1sadtrombone/rf-switch-firmware/boards/RF_control_board_v4.1/schematic.pdf

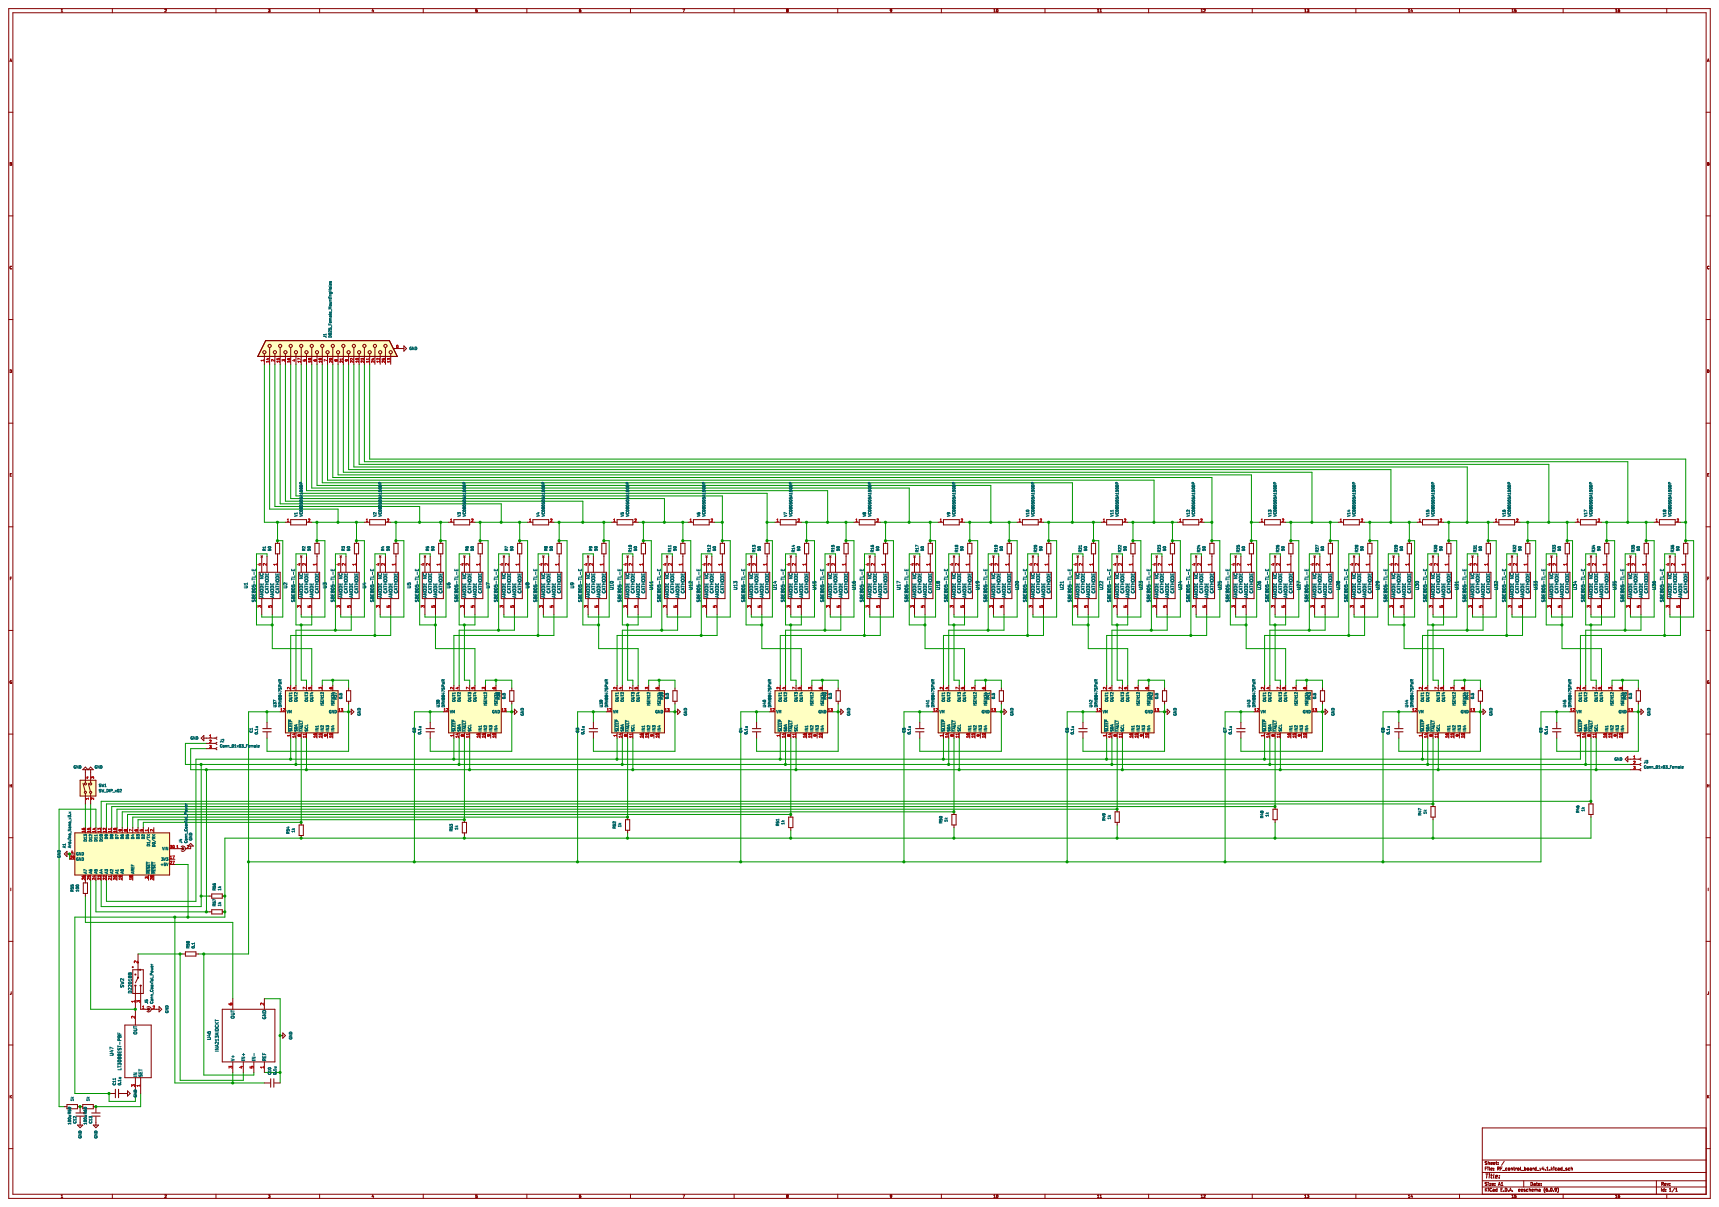
[picture p1: page 1]
