1sadtrombone/rf-switch-firmware/boards/RF_control_board_v2/schematic.pdf

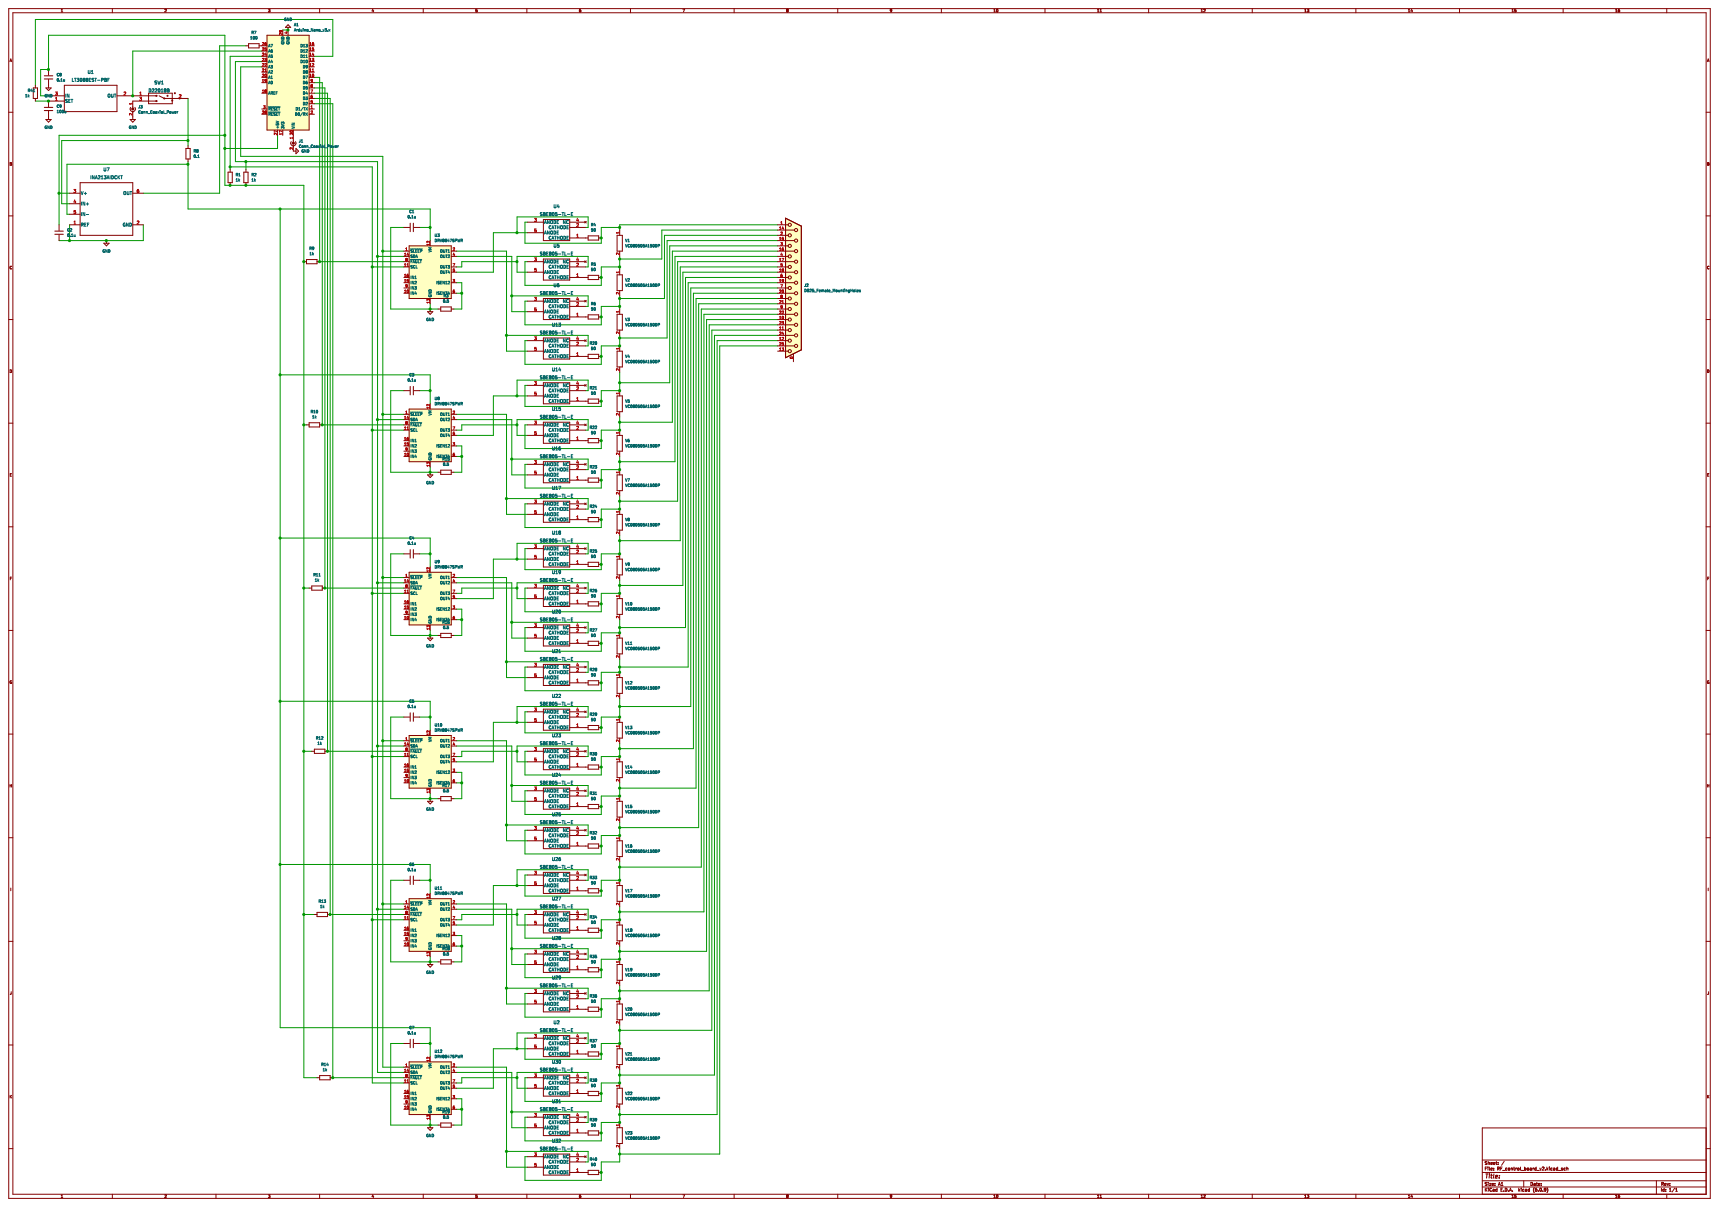
[picture p2: page 1]
