1sadtrombone/rf-switch-firmware/boards/RF_control_board_v2/RF_control_board_v2.kicad_pcb

## KiCad design boards/RF_control_board_v2/RF_control_board_v2.kicad_pcb (2023-06-08, an earlier design)

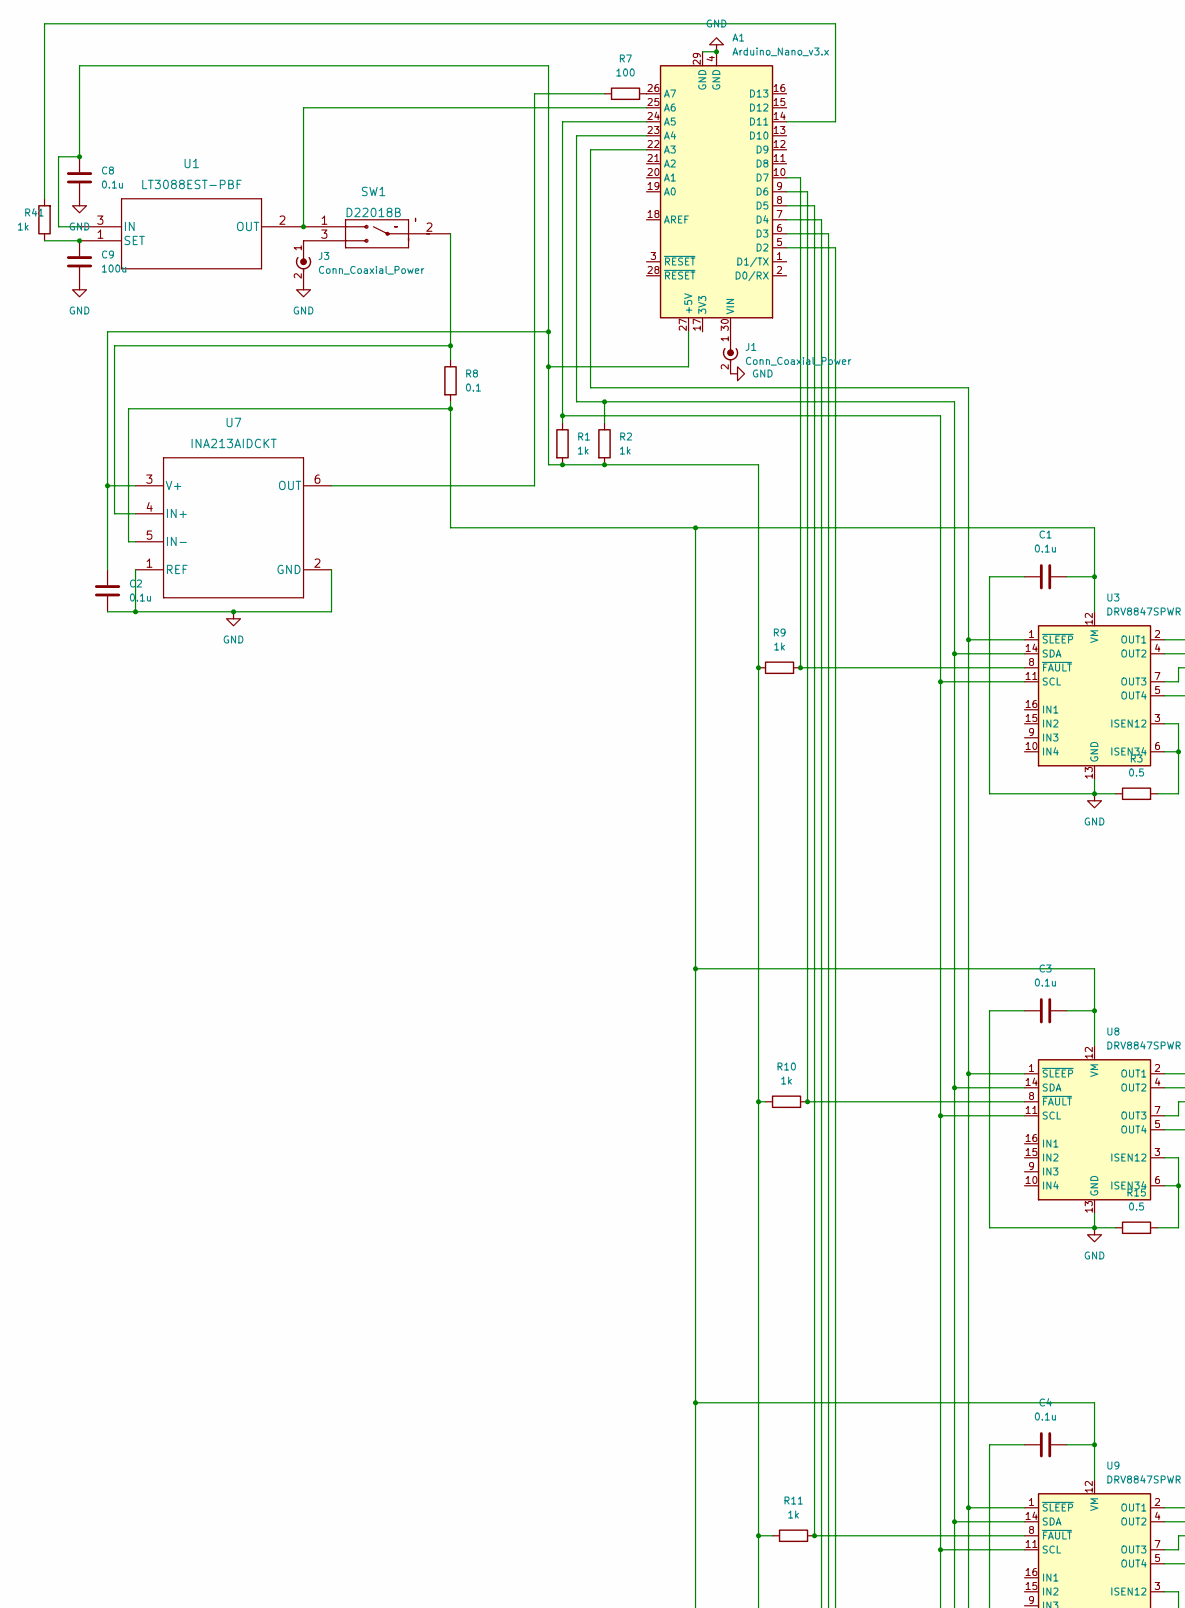
[picture p3: schematic RF_control_board_v2.kicad_sch, part in row 1, column 1]

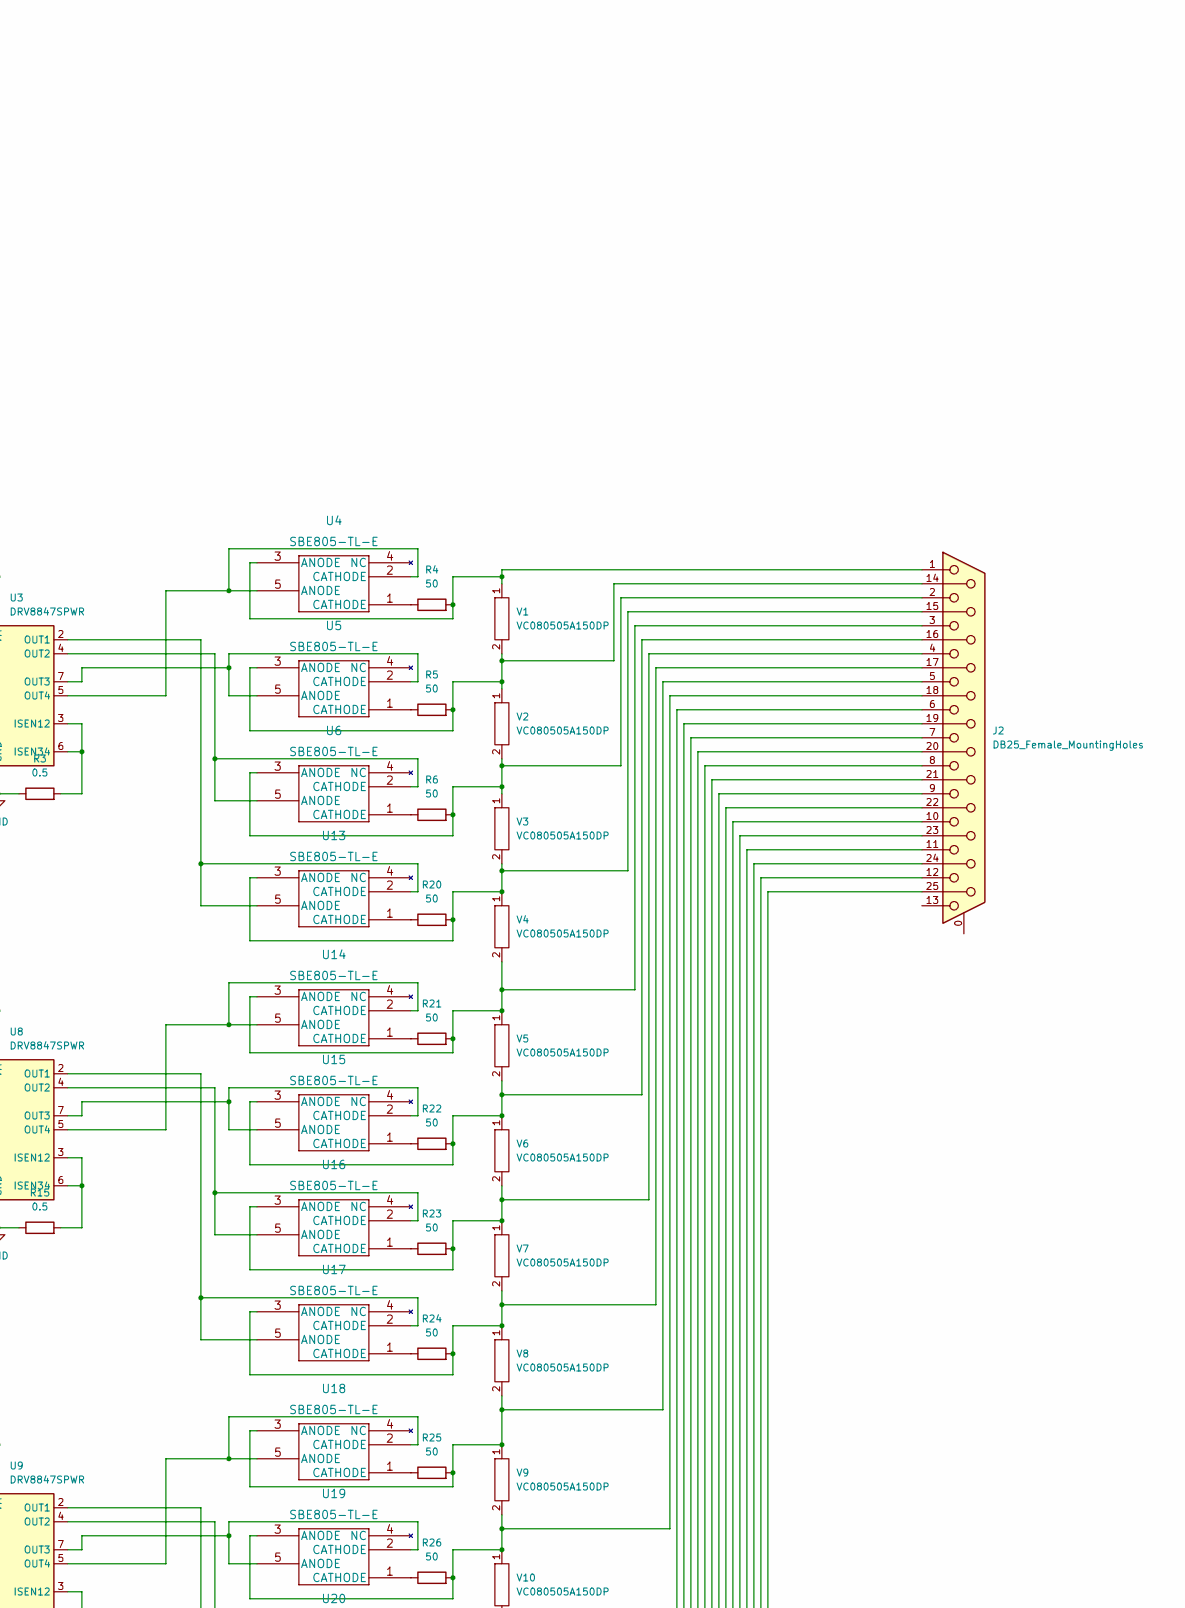
[picture p4: schematic RF_control_board_v2.kicad_sch, part in row 1, column 2]

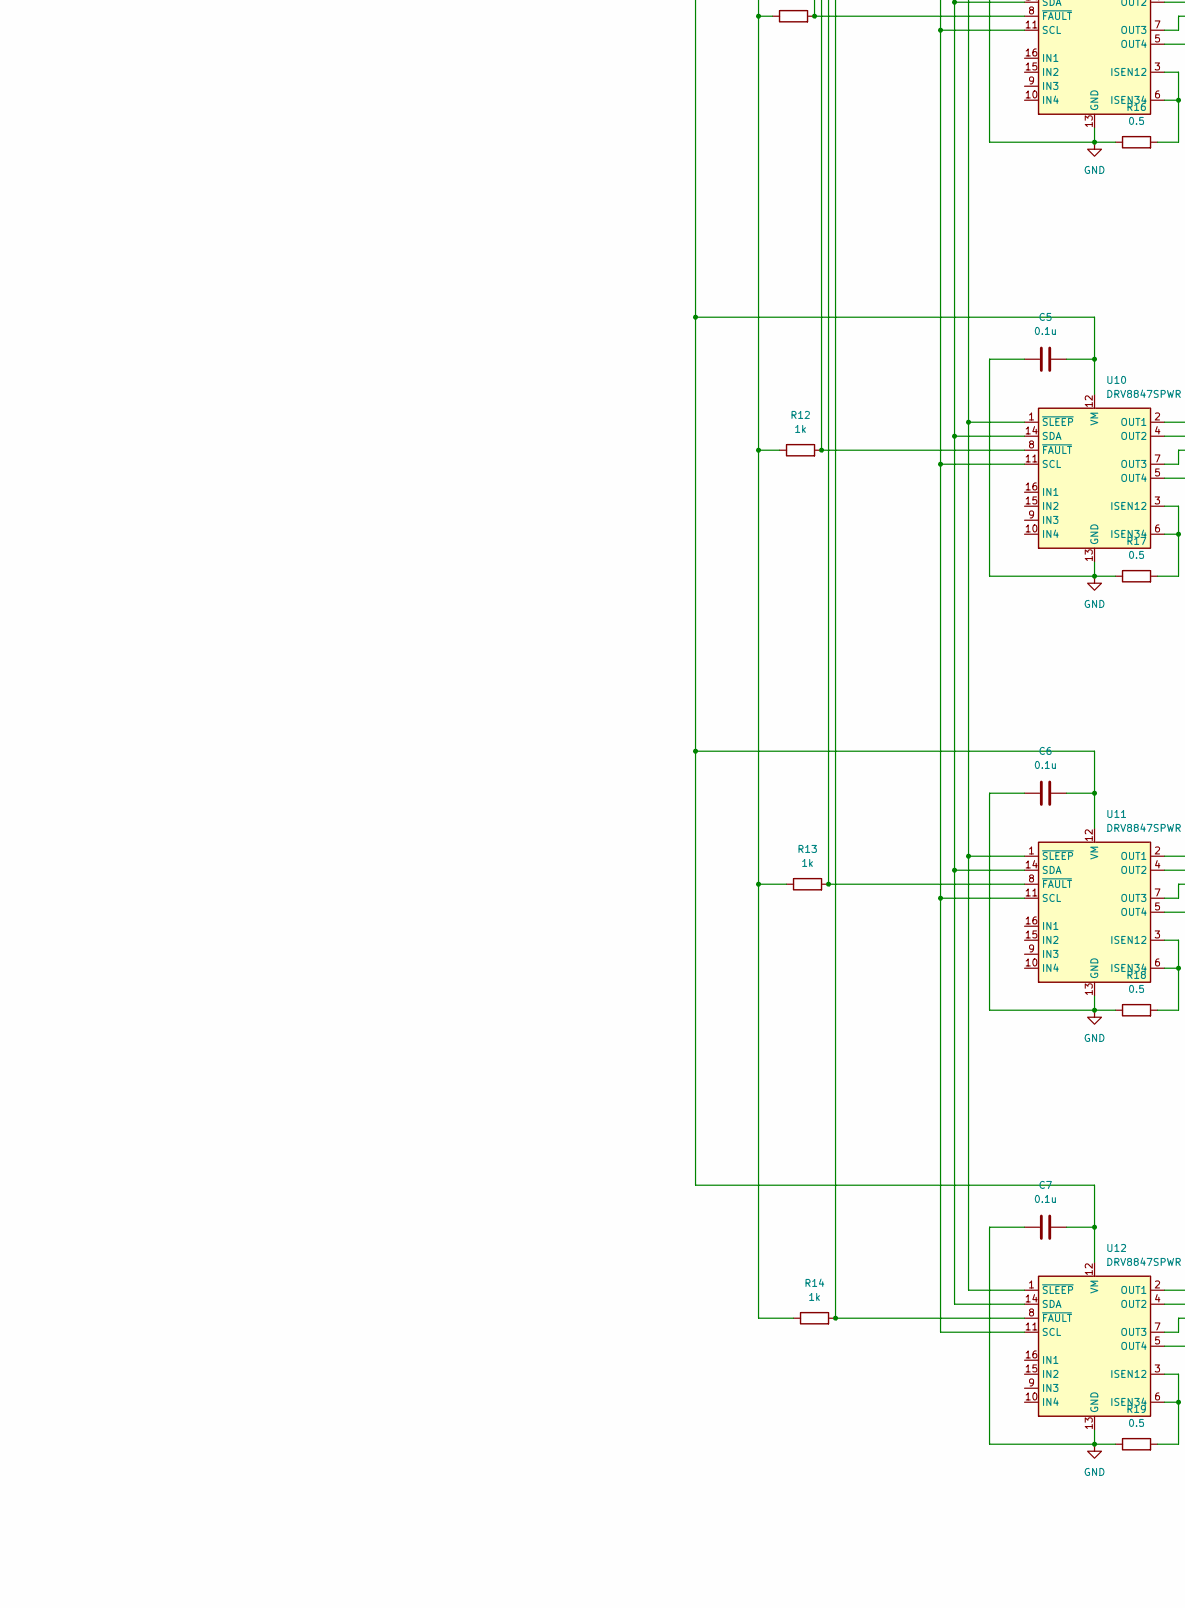
[picture p5: schematic RF_control_board_v2.kicad_sch, part in row 2, column 1]

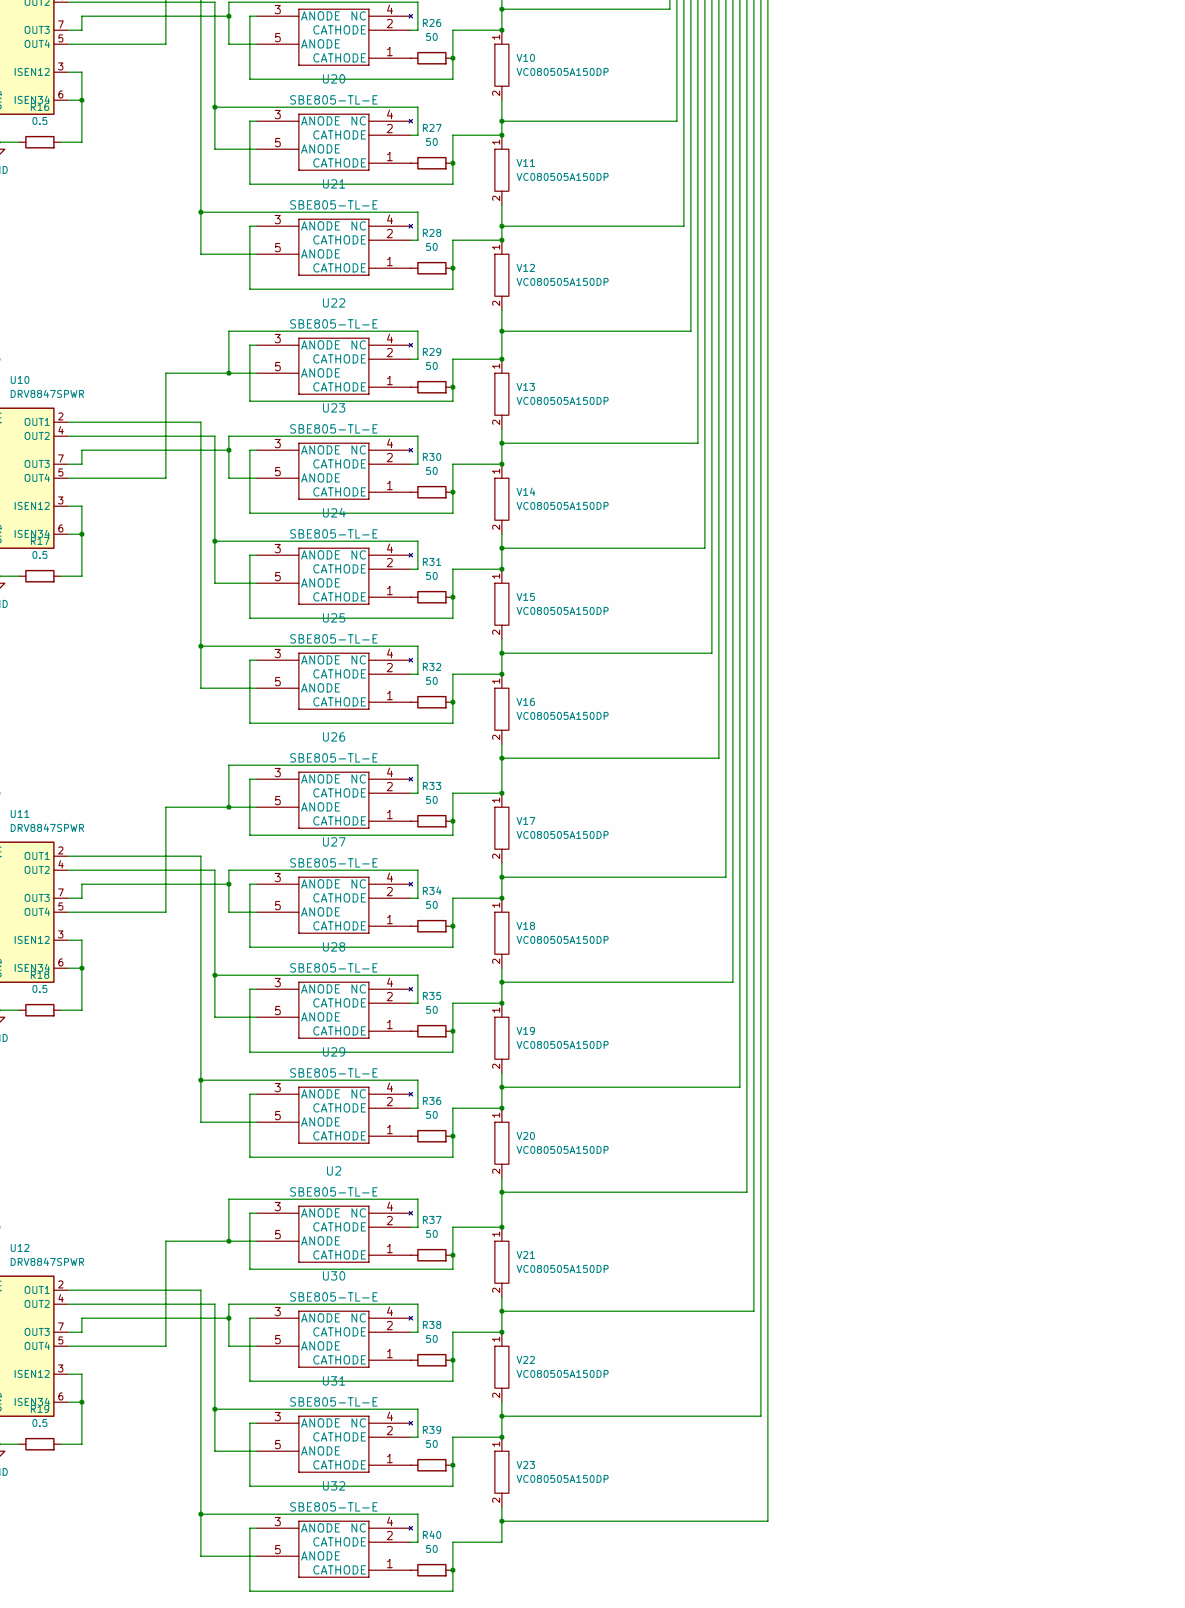
[picture p6: schematic RF_control_board_v2.kicad_sch, part in row 2, column 2]

Parts:
A1: Arduino_Nano_v3.x; Arduino_Nano
C1, C2, C3, C4, C5, C6, C7, C8: 0.1u; C_0603_1608Metric
C9: 100u; C_0603_1608Metric
J1: Conn_Coaxial_Power; BarrelJack_CUI_PJ-063AH_Horizontal
J2: DB25_Female_MountingHoles; DSUB-25_Female_Horizontal_P2.77x2.84mm_EdgePinOffset4.94mm_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
J3: Conn_Coaxial_Power; BNC_Amphenol_B6252HB-NPP3G-50_Horizontal
R1, R2, R9, R10, R11, R12, R13, R14, R41: 1k; R_0603_1608Metric
R3, R15, R16, R17, R18, R19: 0.5; R_0603_1608Metric
R4, R5, R6, R20, R21, R22, R23, R24, R25, R26, R27, R28, R29, R30, R31, R32, R33, R34, R35, R36, R37, R38, R39, R40: 50; R_0603_1608Metric
R7: 100; R_0603_1608Metric
R8: 0.1; R_0603_1608Metric
SW1: D22018B; D22012_B_NKK
U1: LT3088EST-PBF; SOT-223_ST_LIT
U2, U4, U5, U6, U13, U14, U15, U16, U17, U18, U19, U20, U21, U22, U23, U24, U25, U26, U27, U28, U29, U30, U31, U32: SBE805-TL-E; SOT-753_1P6X2P9_ONS
U3, U8, U9, U10, U11, U12: DRV8847SPWR; TSSOP-16_4.4x5mm_P0.65mm
U7: INA213AIDCKT; DCK0006A_N
V1, V2, V3, V4, V5, V6, V7, V8, V9, V10, V11, V12, V13, V14, V15, V16, V17, V18, V19, V20, V21, V22, V23: VC080505A150DP; AVX_0805

Connections:
GND: A1.4 (GND), A1.29 (GND), C1.1, C2.1, C3.1, C4.1, C5.1, C6.1, C7.1, C8.2, C9.2, J1.2 (Ext), J3.2 (Ext), R3.1, R15.1, R16.1, R17.1, R18.1, R19.1, U3.13 (GND), U7.1 (REF), U7.2 (GND), U8.13 (GND), U9.13 (GND), U10.13 (GND), U11.13 (GND), U12.13 (GND)
unnamed: A1.5 (D2), R14.2, U12.8 (~FAULT)
unnamed: A1.6 (D3), R13.2, U11.8 (~FAULT)
unnamed: A1.7 (D4), R12.2, U10.8 (~FAULT)
unnamed: A1.8 (D5), R11.2, U9.8 (~FAULT)
unnamed: A1.9 (D6), R10.2, U8.8 (~FAULT)
unnamed: A1.10 (D7), R9.2, U3.8 (~FAULT)
unnamed: A1.14 (D11), R41.2
unnamed: A1.22 (A3), U3.1 (~SLEEP), U8.1 (~SLEEP), U9.1 (~SLEEP), U10.1 (~SLEEP), U11.1 (~SLEEP), U12.1 (~SLEEP)
unnamed: A1.23 (A4), R2.1, U3.14 (SDA), U8.14 (SDA), U9.14 (SDA), U10.14 (SDA), U11.14 (SDA), U12.14 (SDA)
unnamed: A1.24 (A5), R1.1, U3.11 (SCL), U8.11 (SCL), U9.11 (SCL), U10.11 (SCL), U11.11 (SCL), U12.11 (SCL)
unnamed: A1.25 (A6), SW1.1, U1.2 (OUT)
unnamed: A1.26 (A7), R7.2
unnamed: A1.27 (+5V), C2.2, C8.1, R1.2, R2.2, R9.1, R10.1, R11.1, R12.1, R13.1, R14.1, U1.3 (IN), U7.3 (V+)
unnamed: A1.30 (VIN), J1.1 (In)
unnamed: C1.2, C3.2, C4.2, C5.2, C6.2, C7.2, R8.2, U3.12 (VM), U7.5 (IN-), U8.12 (VM), U9.12 (VM), U10.12 (VM), U11.12 (VM), U12.12 (VM)
unnamed: C9.1, R41.1, U1.1 (SET)
unnamed: J2.1, R4.2, U4.3 (ANODE), V1.1
unnamed: J2.2, R6.2, U6.3 (ANODE), V2.2, V3.1
unnamed: J2.3, R21.2, U14.3 (ANODE), V4.2, V5.1
unnamed: J2.4, R23.2, U16.3 (ANODE), V6.2, V7.1
unnamed: J2.5, R25.2, U18.3 (ANODE), V8.2, V9.1
unnamed: J2.6, R27.2, U20.3 (ANODE), V10.2, V11.1
unnamed: J2.7, R29.2, U22.3 (ANODE), V12.2, V13.1
unnamed: J2.8, R31.2, U24.3 (ANODE), V14.2, V15.1
unnamed: J2.9, R33.2, U26.3 (ANODE), V16.2, V17.1
unnamed: J2.10, R35.2, U28.3 (ANODE), V18.2, V19.1
unnamed: J2.11, R37.2, U2.3 (ANODE), V20.2, V21.1
unnamed: J2.12, R39.2, U31.3 (ANODE), V22.2, V23.1
unnamed: J2.14, R5.2, U5.3 (ANODE), V1.2, V2.1
unnamed: J2.15, R20.2, U13.3 (ANODE), V3.2, V4.1
unnamed: J2.16, R22.2, U15.3 (ANODE), V5.2, V6.1
unnamed: J2.17, R24.2, U17.3 (ANODE), V7.2, V8.1
unnamed: J2.18, R26.2, U19.3 (ANODE), V9.2, V10.1
unnamed: J2.19, R28.2, U21.3 (ANODE), V11.2, V12.1
unnamed: J2.20, R30.2, U23.3 (ANODE), V13.2, V14.1
unnamed: J2.21, R32.2, U25.3 (ANODE), V15.2, V16.1
unnamed: J2.22, R34.2, U27.3 (ANODE), V17.2, V18.1
unnamed: J2.23, R36.2, U29.3 (ANODE), V19.2, V20.1
unnamed: J2.24, R38.2, U30.3 (ANODE), V21.2, V22.1
unnamed: J2.25, R40.2, U32.3 (ANODE), V23.2
unnamed: J3.1 (In), SW1.3
unnamed: R3.2, U3.3 (ISEN12), U3.6 (ISEN34)
unnamed: R4.1, U4.1 (CATHODE)
unnamed: R5.1, U5.1 (CATHODE)
unnamed: R6.1, U6.1 (CATHODE)
unnamed: R7.1, U7.6 (OUT)
unnamed: R8.1, SW1.2, U7.4 (IN+)
unnamed: R15.2, U8.3 (ISEN12), U8.6 (ISEN34)
unnamed: R16.2, U9.3 (ISEN12), U9.6 (ISEN34)
unnamed: R17.2, U10.3 (ISEN12), U10.6 (ISEN34)
unnamed: R18.2, U11.3 (ISEN12), U11.6 (ISEN34)
unnamed: R19.2, U12.3 (ISEN12), U12.6 (ISEN34)
unnamed: R20.1, U13.1 (CATHODE)
unnamed: R21.1, U14.1 (CATHODE)
unnamed: R22.1, U15.1 (CATHODE)
unnamed: R23.1, U16.1 (CATHODE)
unnamed: R24.1, U17.1 (CATHODE)
unnamed: R25.1, U18.1 (CATHODE)
unnamed: R26.1, U19.1 (CATHODE)
unnamed: R27.1, U20.1 (CATHODE)
unnamed: R28.1, U21.1 (CATHODE)
unnamed: R29.1, U22.1 (CATHODE)
unnamed: R30.1, U23.1 (CATHODE)
unnamed: R31.1, U24.1 (CATHODE)
unnamed: R32.1, U25.1 (CATHODE)
unnamed: R33.1, U26.1 (CATHODE)
unnamed: R34.1, U27.1 (CATHODE)
unnamed: R35.1, U28.1 (CATHODE)
unnamed: R36.1, U29.1 (CATHODE)
unnamed: R37.1, U2.1 (CATHODE)
unnamed: R38.1, U30.1 (CATHODE)
unnamed: R39.1, U31.1 (CATHODE)
unnamed: R40.1, U32.1 (CATHODE)
unnamed: U3.4 (OUT2), U6.2 (CATHODE), U6.5 (ANODE)
unnamed: U3.5 (OUT4), U4.2 (CATHODE), U4.5 (ANODE)
unnamed: U3.7 (OUT3), U5.2 (CATHODE), U5.5 (ANODE)
unnamed: U10.2 (OUT1), U25.2 (CATHODE), U25.5 (ANODE)
unnamed: U10.4 (OUT2), U24.2 (CATHODE), U24.5 (ANODE)
unnamed: U10.5 (OUT4), U22.2 (CATHODE), U22.5 (ANODE)
unnamed: U10.7 (OUT3), U23.2 (CATHODE), U23.5 (ANODE)
unnamed: U11.2 (OUT1), U29.2 (CATHODE), U29.5 (ANODE)
unnamed: U11.4 (OUT2), U28.2 (CATHODE), U28.5 (ANODE)
unnamed: U11.5 (OUT4), U26.2 (CATHODE), U26.5 (ANODE)
unnamed: U11.7 (OUT3), U27.2 (CATHODE), U27.5 (ANODE)
unnamed: U12.2 (OUT1), U32.2 (CATHODE), U32.5 (ANODE)
unnamed: U12.4 (OUT2), U31.2 (CATHODE), U31.5 (ANODE)
unnamed: U2.2 (CATHODE), U2.5 (ANODE), U12.5 (OUT4)
unnamed: U12.7 (OUT3), U30.2 (CATHODE), U30.5 (ANODE)
unnamed: U3.2 (OUT1), U13.2 (CATHODE), U13.5 (ANODE)
unnamed: U8.5 (OUT4), U14.2 (CATHODE), U14.5 (ANODE)
unnamed: U8.7 (OUT3), U15.2 (CATHODE), U15.5 (ANODE)
unnamed: U8.4 (OUT2), U16.2 (CATHODE), U16.5 (ANODE)
unnamed: U8.2 (OUT1), U17.2 (CATHODE), U17.5 (ANODE)
unnamed: U9.5 (OUT4), U18.2 (CATHODE), U18.5 (ANODE)
unnamed: U9.7 (OUT3), U19.2 (CATHODE), U19.5 (ANODE)
unnamed: U9.4 (OUT2), U20.2 (CATHODE), U20.5 (ANODE)
unnamed: U9.2 (OUT1), U21.2 (CATHODE), U21.5 (ANODE)

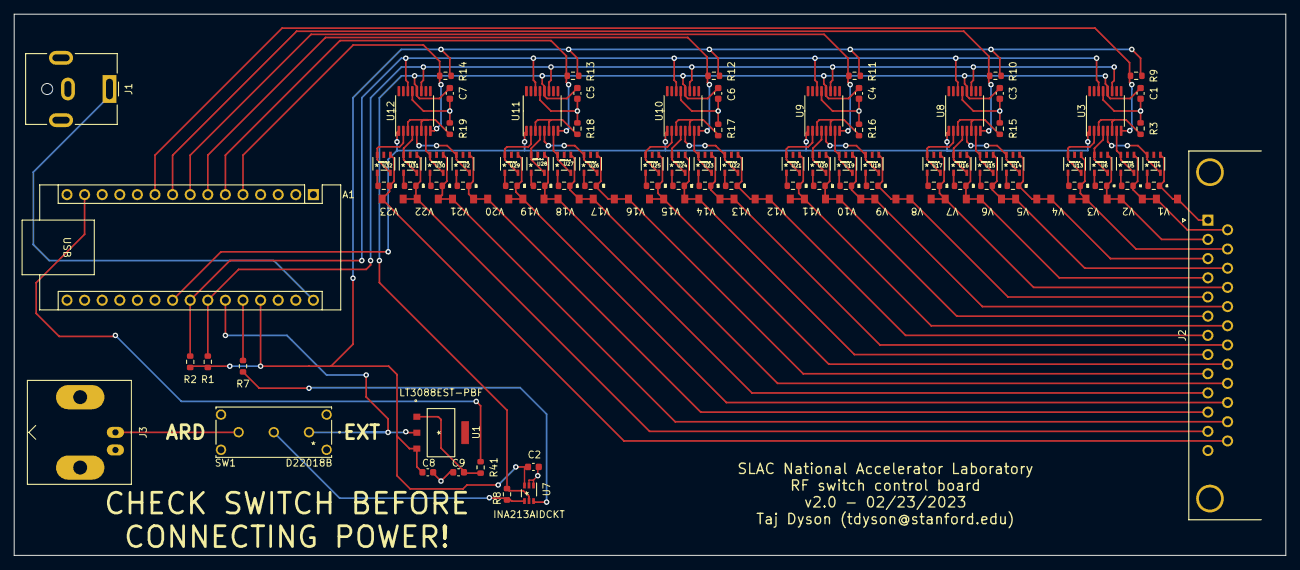
[picture p7: board RF_control_board_v2.kicad_pcb from above]

Board: 2 copper layers, 183.5 x 78.1 mm, 110 parts (0 on the bottom side), 98 nets.
