1sadtrombone/rf-switch-firmware/boards/RF_control_board_v4.1/RF_control_board_v4.1.kicad_pcb

## KiCad design boards/RF_control_board_v4.1/RF_control_board_v4.1.kicad_pcb (2023-06-08)

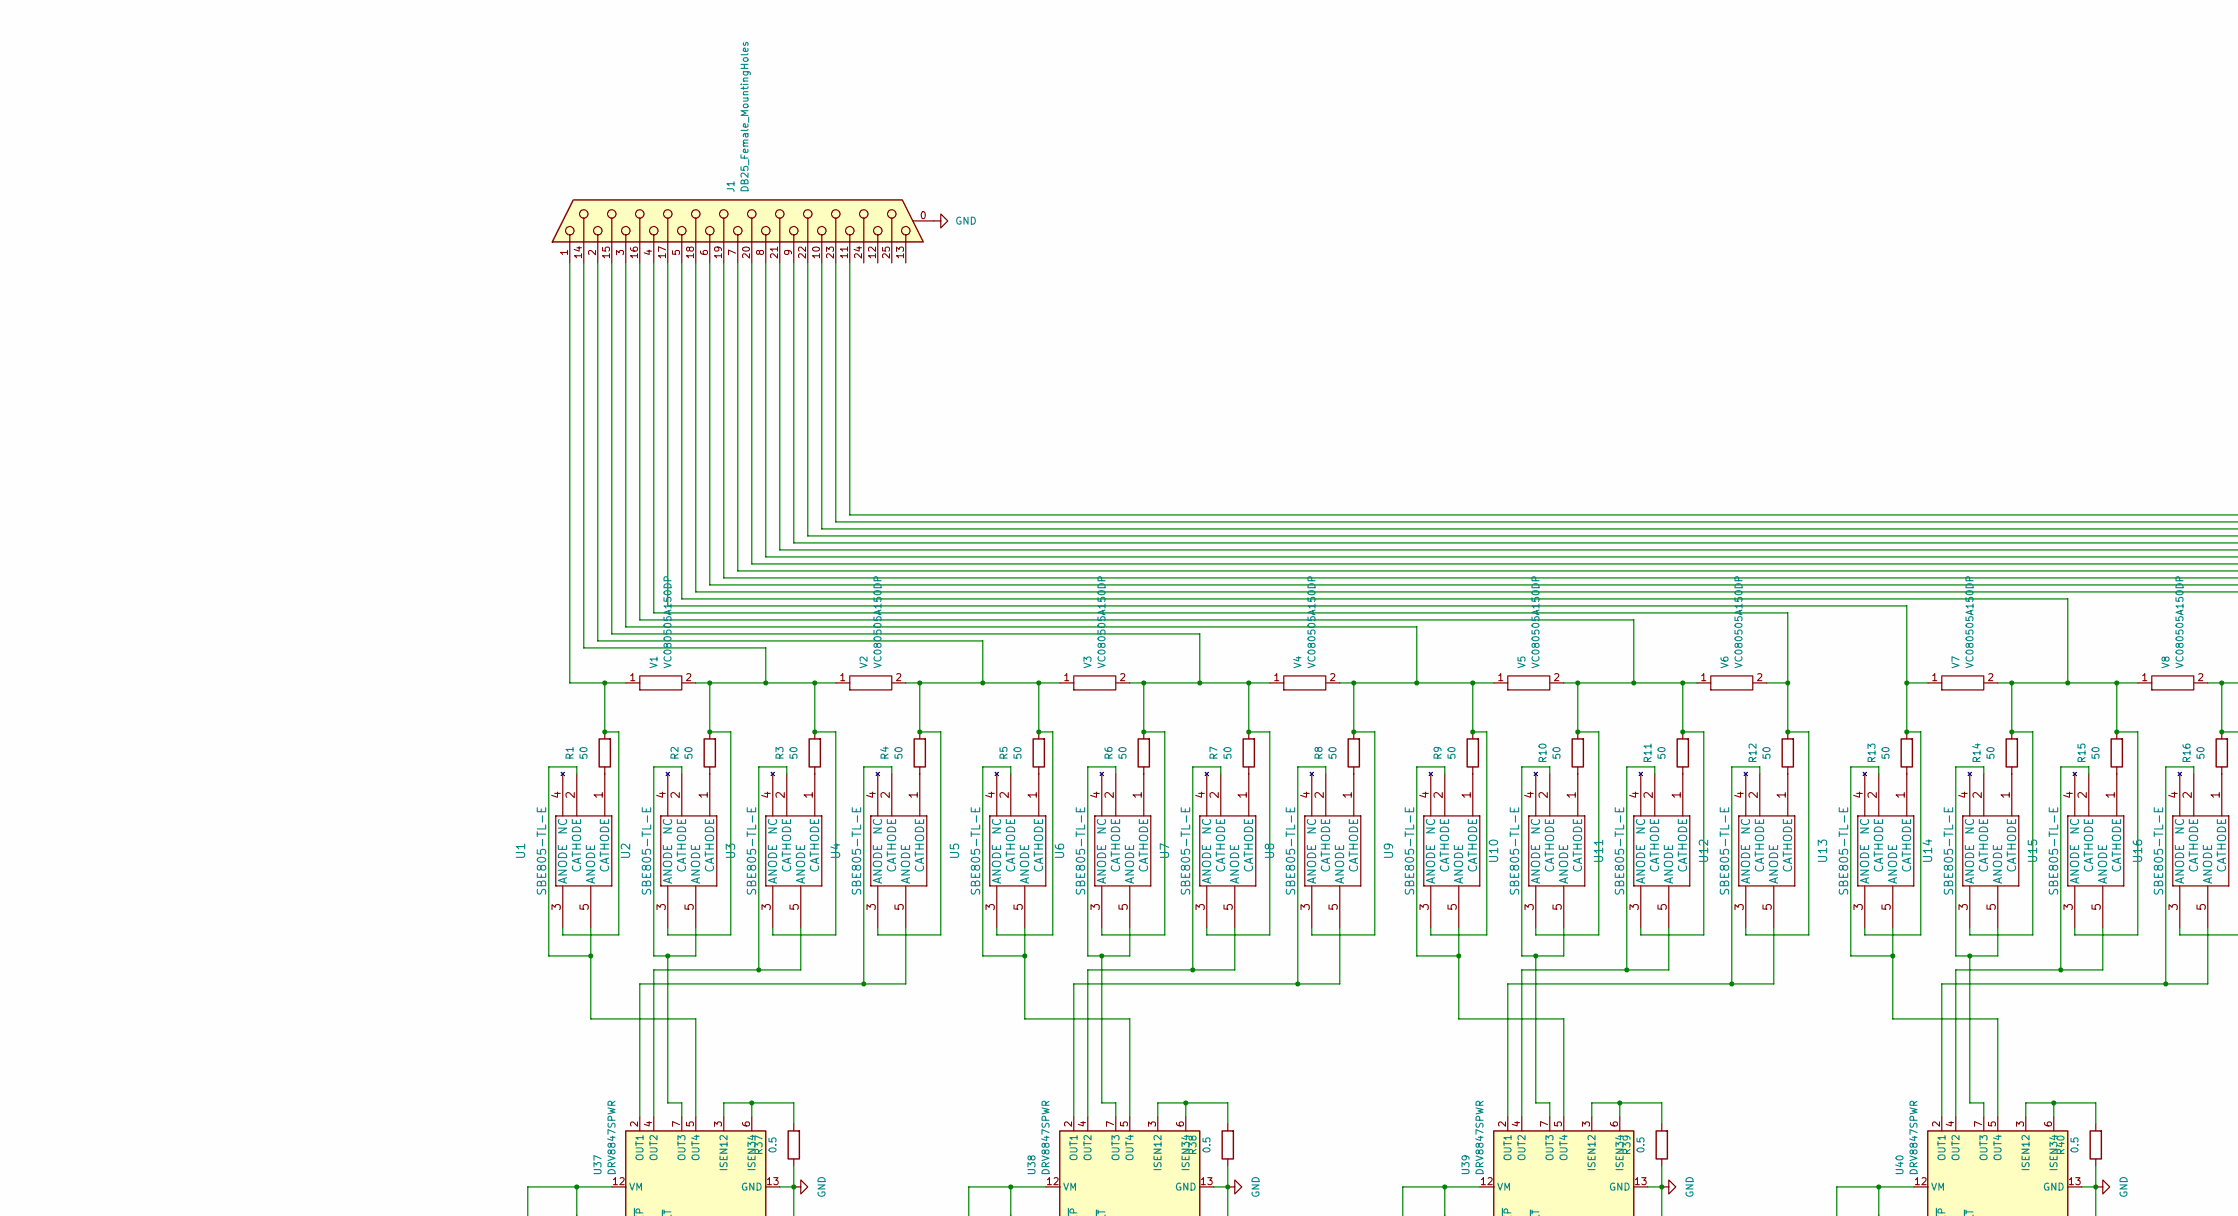
[picture p8: schematic RF_control_board_v4.1.kicad_sch, part in row 1, column 1]

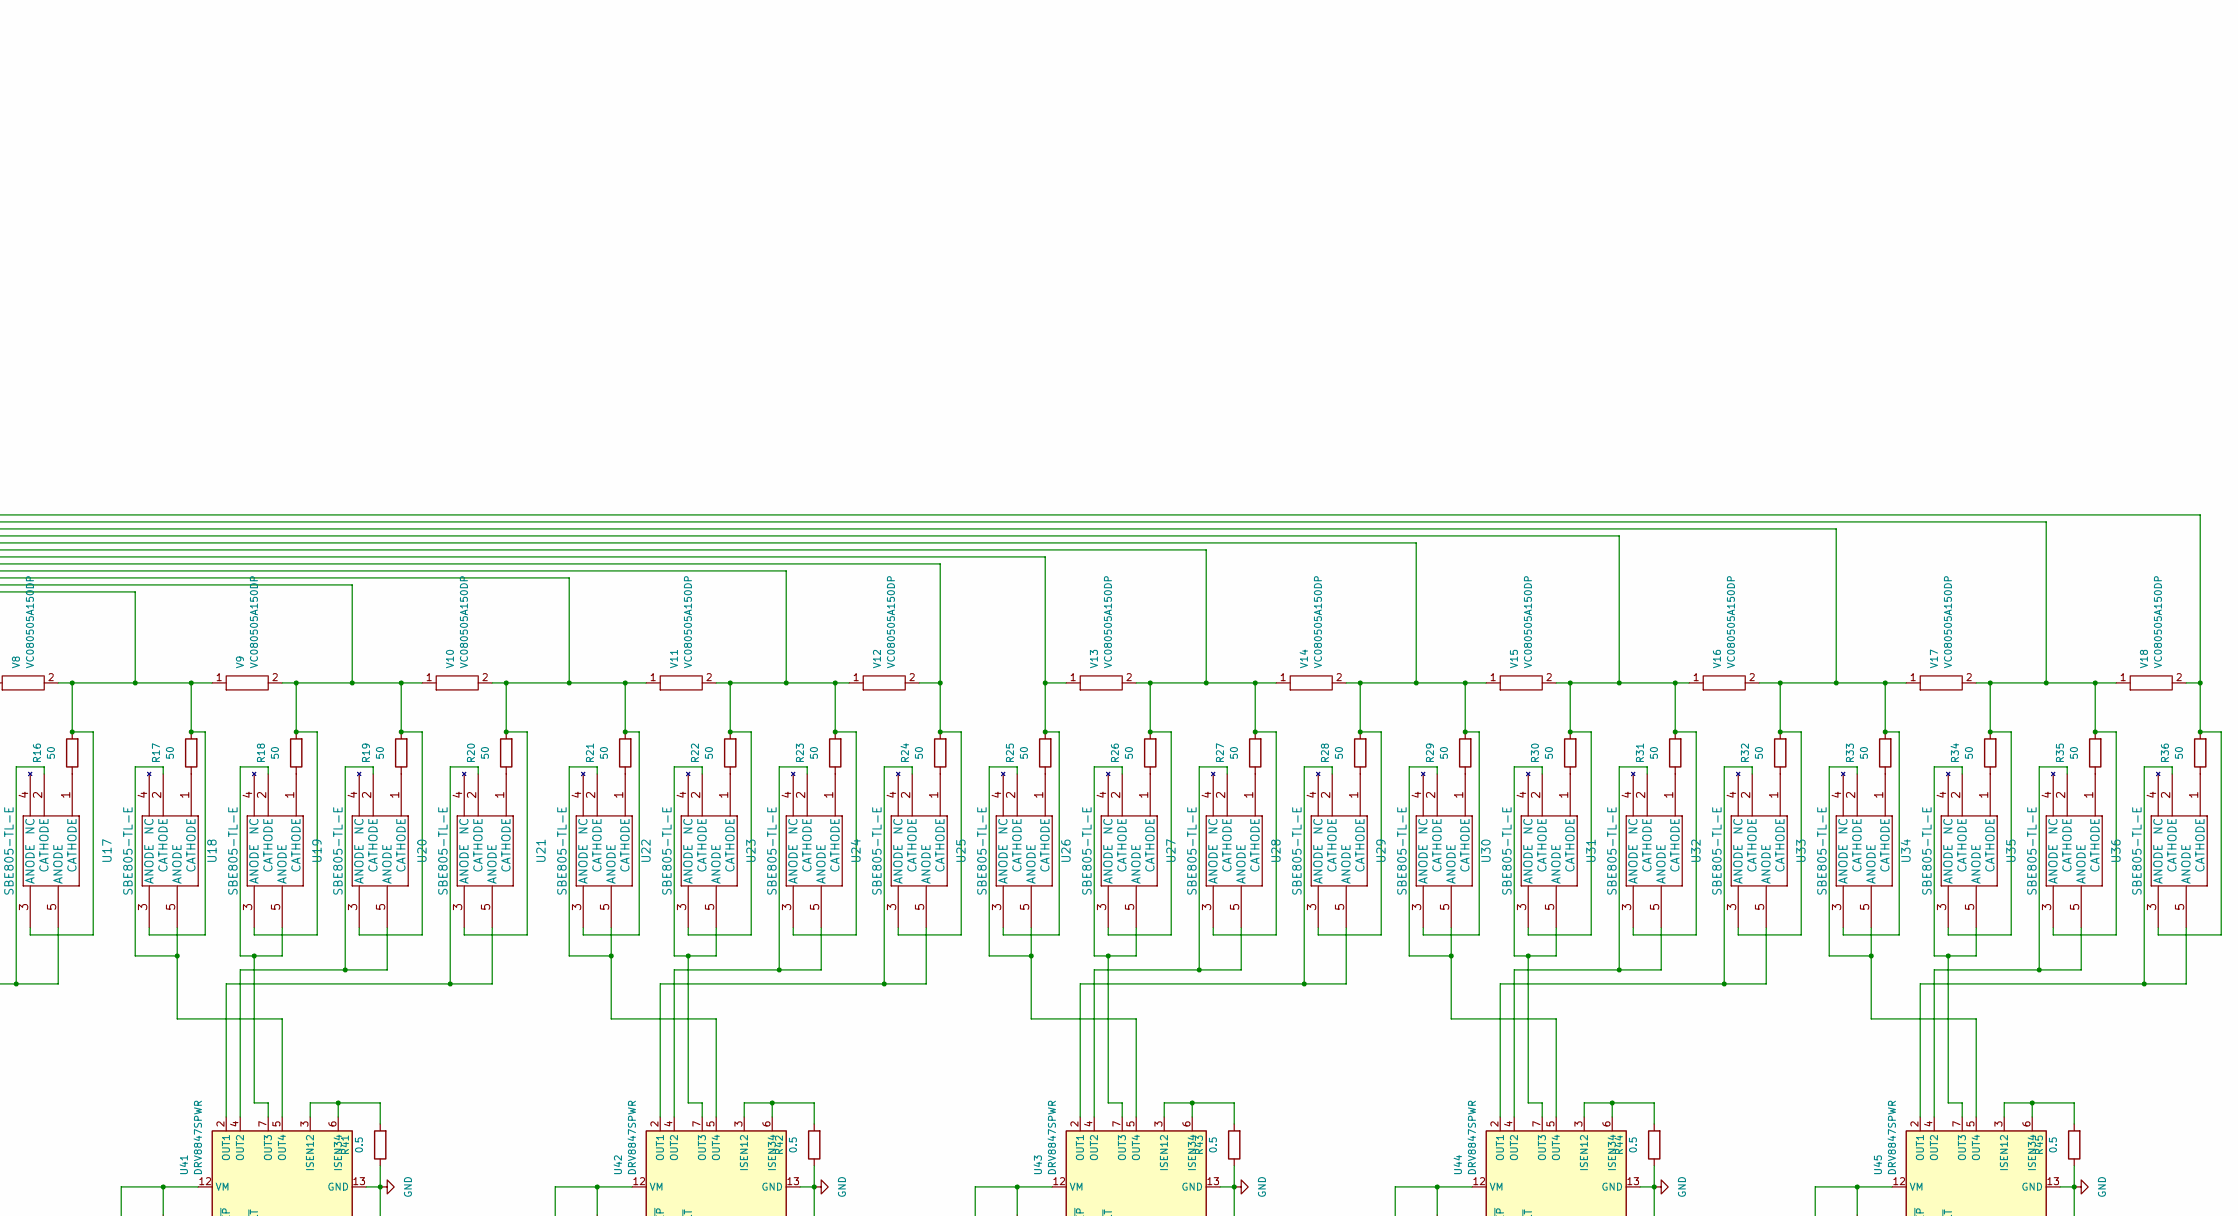
[picture p9: schematic RF_control_board_v4.1.kicad_sch, part in row 1, column 2]

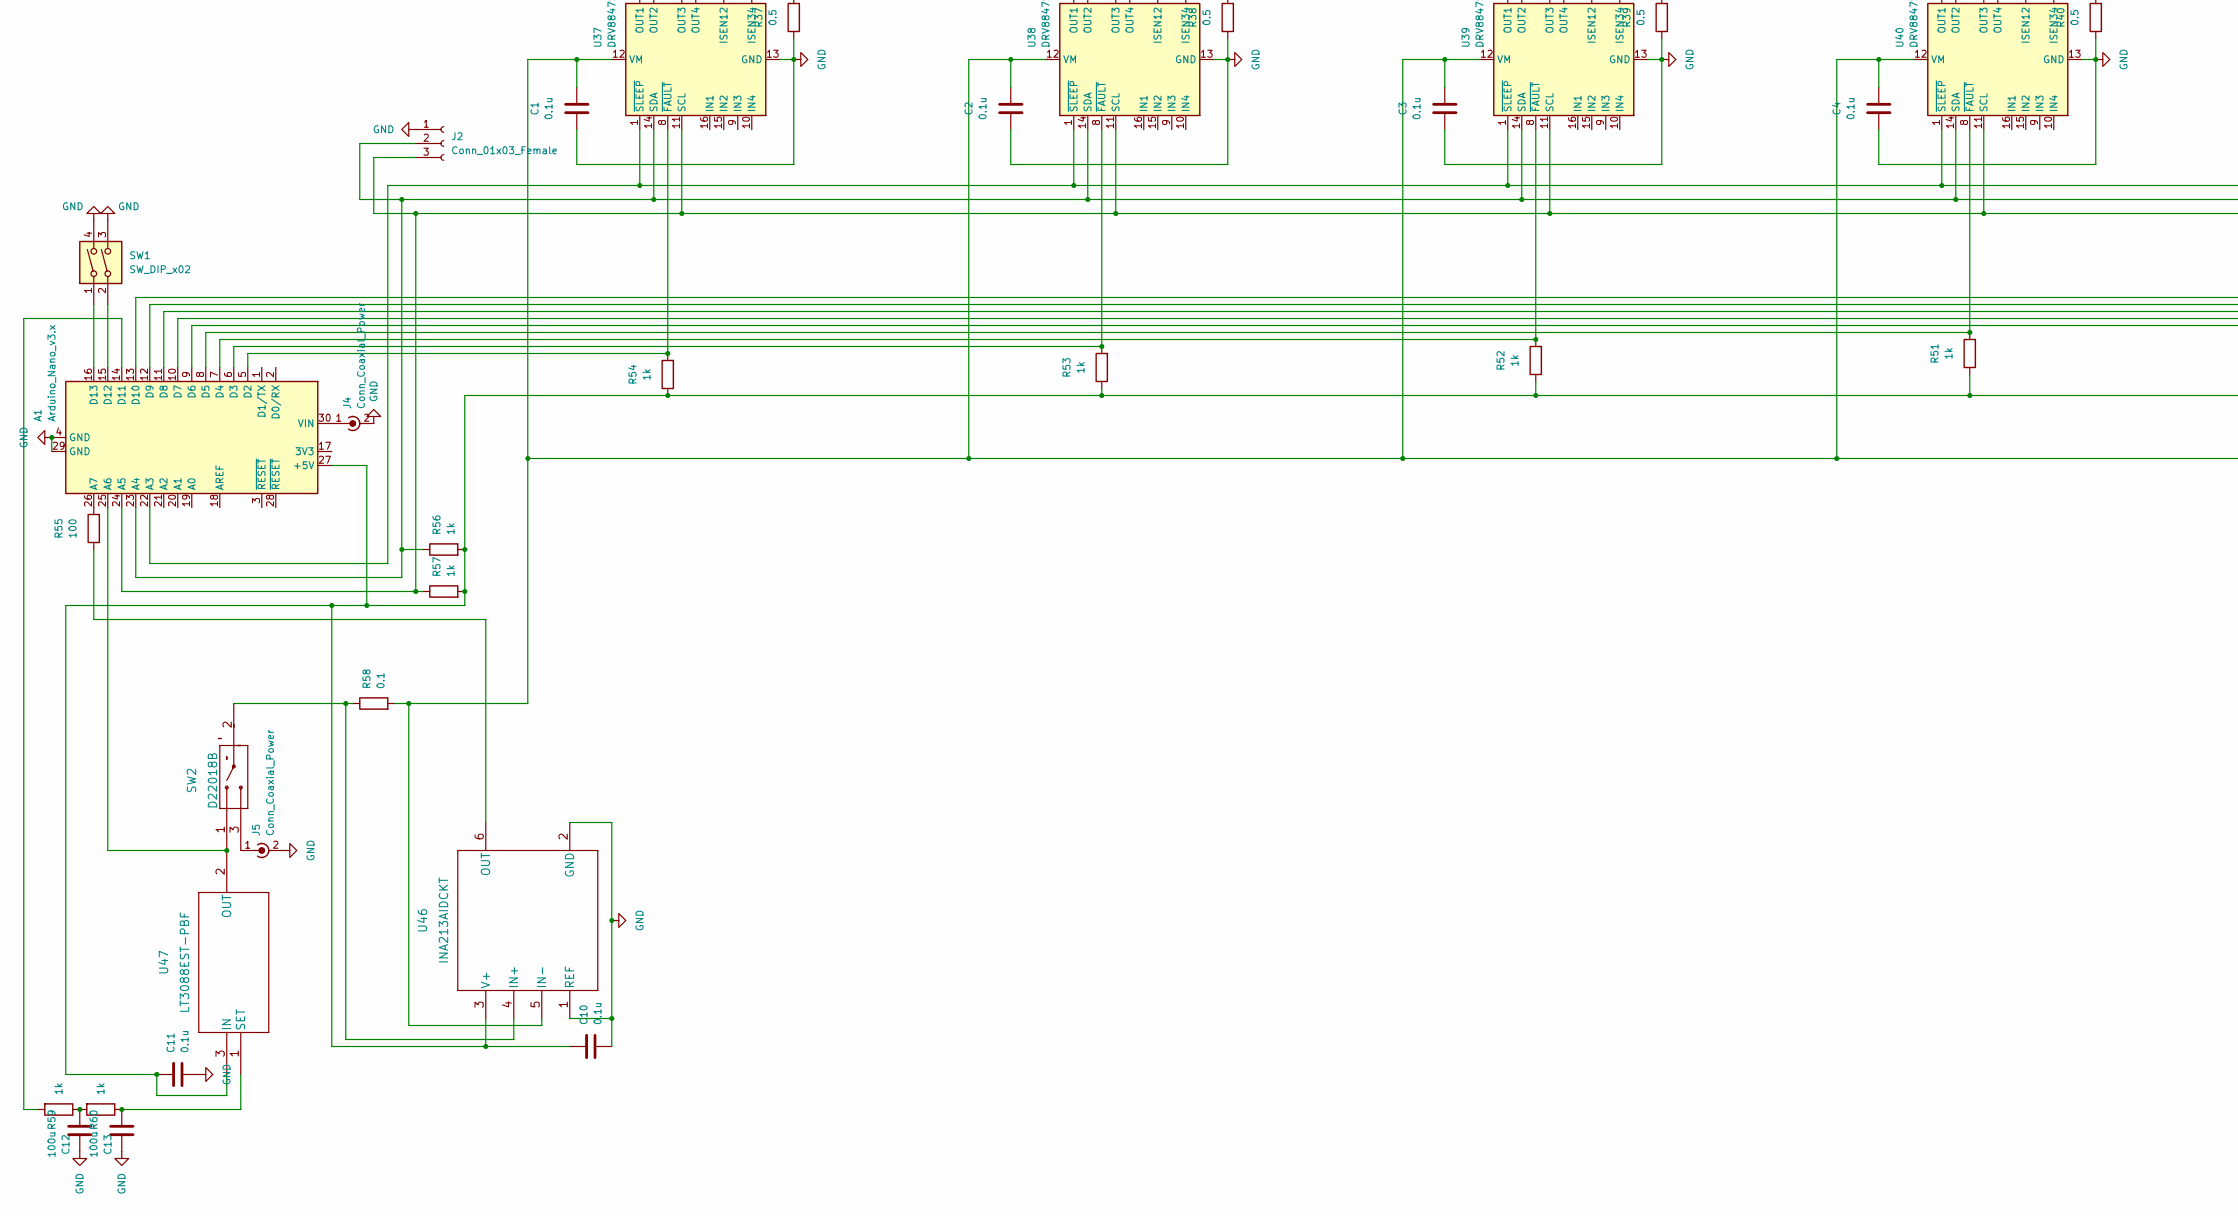
[picture p10: schematic RF_control_board_v4.1.kicad_sch, part in row 2, column 1]

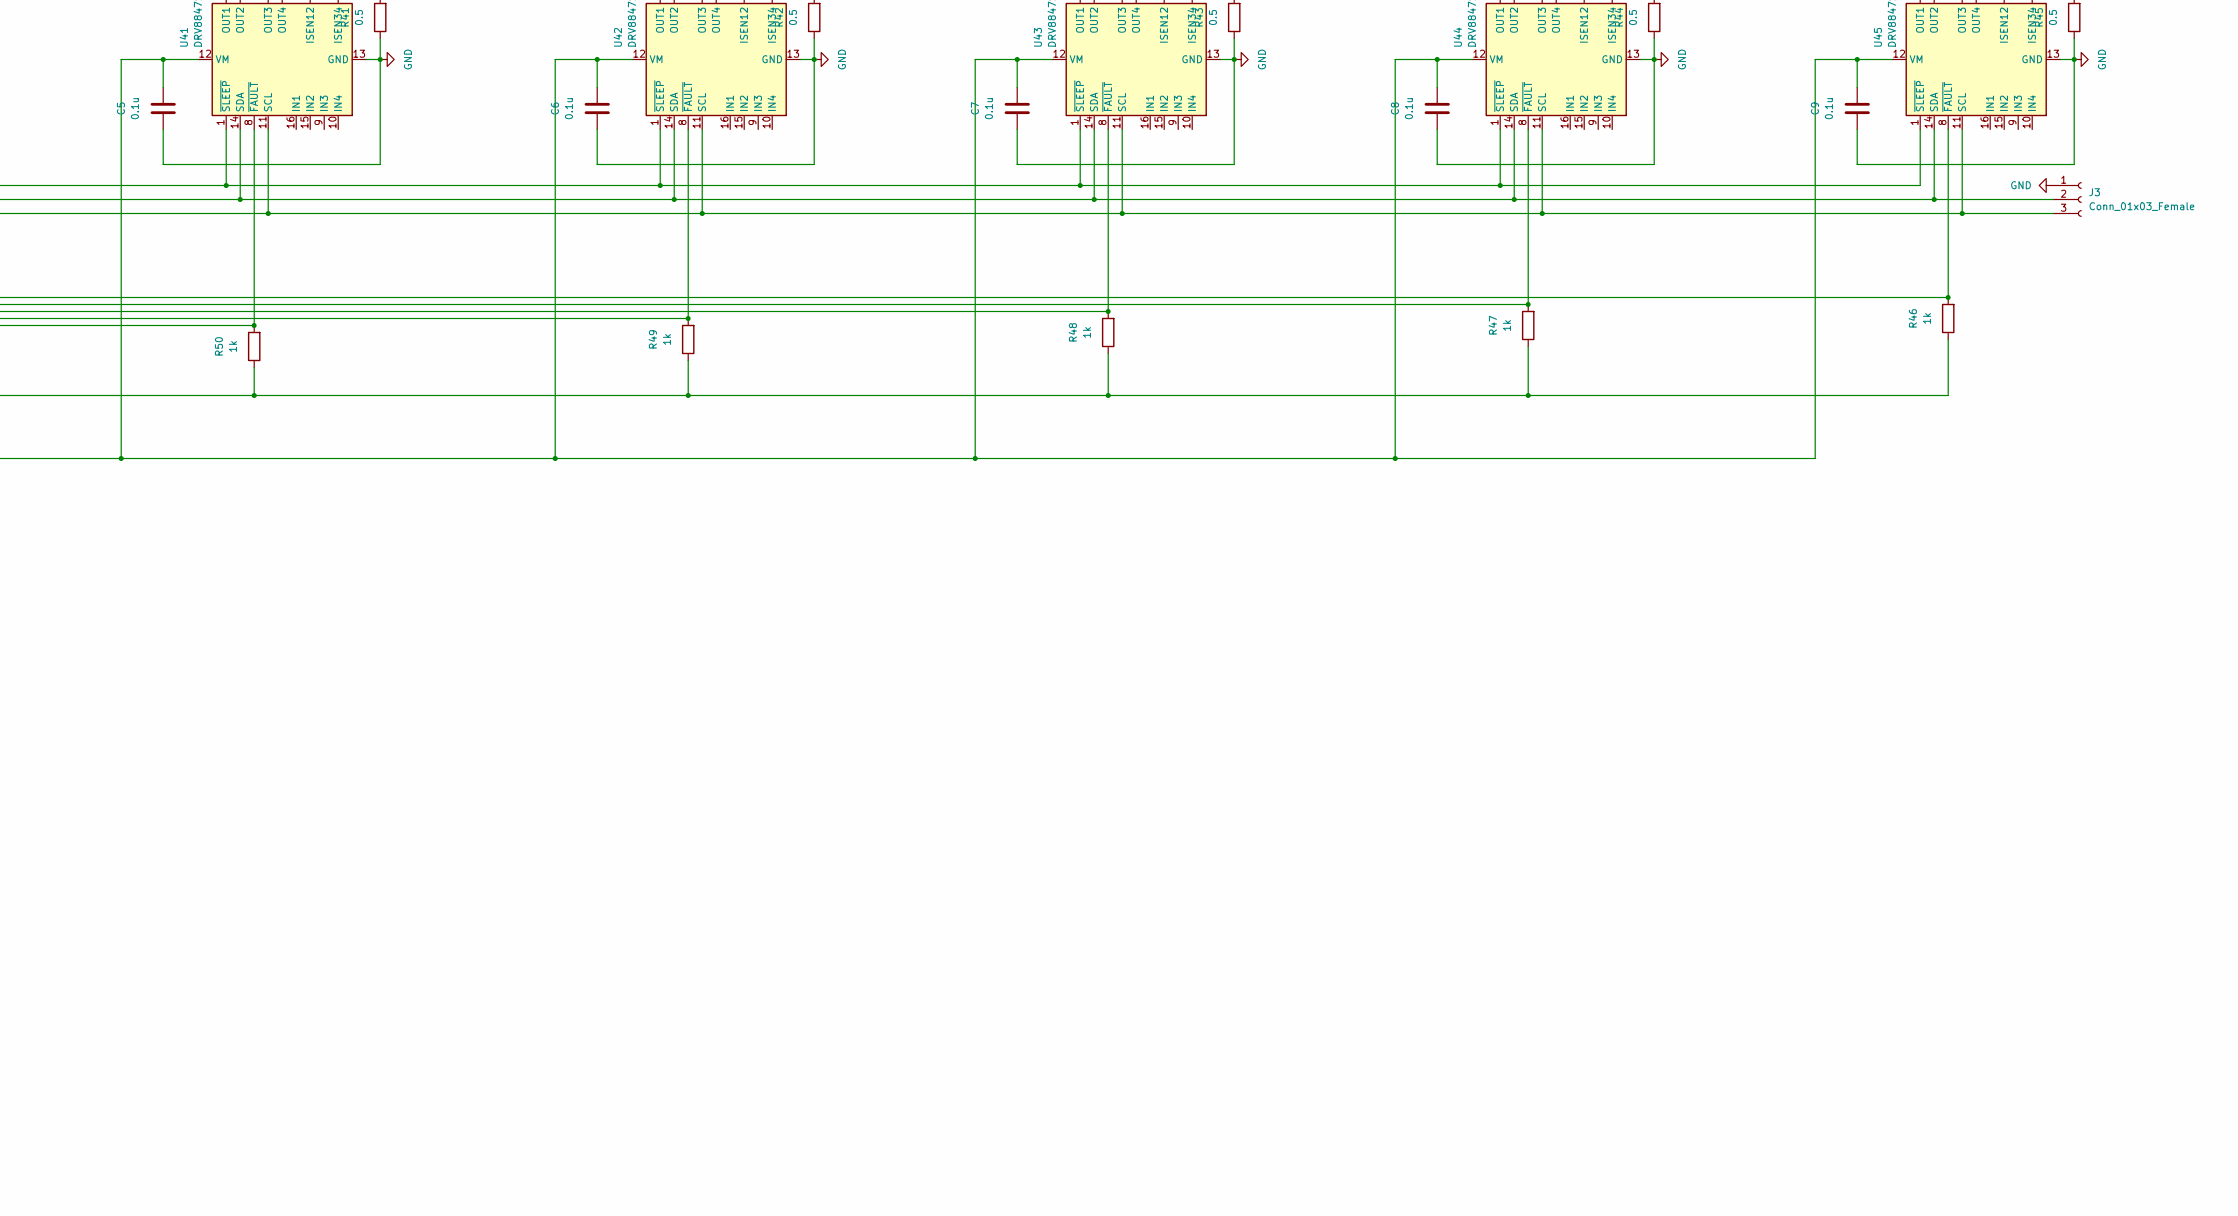
[picture p11: schematic RF_control_board_v4.1.kicad_sch, part in row 2, column 2]

Parts:
A1: Arduino_Nano_v3.x; Arduino_Nano
C1, C2, C3, C4, C5, C6, C7, C8, C9, C10, C11: 0.1u; C_0603_1608Metric
C12, C13: 100u; C_0805_2012Metric
J1: DB25_Female_MountingHoles; DSUB-25_Female_Horizontal_P2.77x2.84mm_EdgePinOffset4.94mm_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
J2, J3: Conn_01x03_Female; JST_GH_BM03B-GHS-TBT_1x03-1MP_P1.25mm_Vertical
J4: Conn_Coaxial_Power; BarrelJack_CUI_PJ-063AH_Horizontal
J5: Conn_Coaxial_Power; BNC_Amphenol_B6252HB-NPP3G-50_Horizontal
R1, R2, R3, R4, R5, R6, R7, R8, R9, R10, R11, R12, R13, R14, R15, R16, R17, R18, R19, R20, R21, R22, R23, R24, R25, R26, R27, R28, R29, R30, R31, R32, R33, R34, R35, R36: 50; R_0603_1608Metric
R37, R38, R39, R40, R41, R42, R43, R44, R45: 0.5; R_0603_1608Metric
R46, R47, R48, R49, R50, R51, R52, R53, R54, R56, R57, R59, R60: 1k; R_0603_1608Metric
R55: 100; R_0603_1608Metric
R58: 0.1; R_0603_1608Metric
SW1: SW_DIP_x02; SW_DIP_SPSTx02_Slide_9.78x7.26mm_W7.62mm_P2.54mm
SW2: D22018B; D22012_B_NKK
U1, U2, U3, U4, U5, U6, U7, U8, U9, U10, U11, U12, U13, U14, U15, U16, U17, U18, U19, U20, U21, U22, U23, U24, U25, U26, U27, U28, U29, U30, U31, U32, U33, U34, U35, U36: SBE805-TL-E; SOT-753_1P6X2P9_ONS
U37, U38, U39, U40, U41, U42, U43, U44, U45: DRV8847SPWR; TSSOP-16_4.4x5mm_P0.65mm
U46: INA213AIDCKT; DCK0006A_N
U47: LT3088EST-PBF; SOT-223_ST_LIT
V1, V2, V3, V4, V5, V6, V7, V8, V9, V10, V11, V12, V13, V14, V15, V16, V17, V18: VC080505A150DP; R_0805_2012Metric

Connections:
GND: A1.4 (GND), A1.29 (GND), C1.1, C2.1, C3.1, C4.1, C5.1, C6.1, C7.1, C8.1, C9.1, C10.1, C11.2, C12.2, C13.2, J1.0 (PAD), J2.1, J3.1, J4.2 (Ext), J5.2 (Ext), R37.1, R38.1, R39.1, R40.1, R41.1, R42.1, R43.1, R44.1, R45.1, SW1.3, SW1.4, U37.13 (GND), U38.13 (GND), U39.13 (GND), U40.13 (GND), U41.13 (GND), U42.13 (GND), U43.13 (GND), U44.13 (GND), U45.13 (GND), U46.1 (REF), U46.2 (GND)
unnamed: A1.5 (D2), R54.2, U37.8 (~FAULT)
unnamed: A1.6 (D3), R53.2, U38.8 (~FAULT)
unnamed: A1.7 (D4), R52.2, U39.8 (~FAULT)
unnamed: A1.8 (D5), R51.2, U40.8 (~FAULT)
unnamed: A1.9 (D6), R50.2, U41.8 (~FAULT)
unnamed: A1.10 (D7), R49.2, U42.8 (~FAULT)
unnamed: A1.11 (D8), R48.2, U43.8 (~FAULT)
unnamed: A1.12 (D9), R47.2, U44.8 (~FAULT)
unnamed: A1.13 (D10), R46.2, U45.8 (~FAULT)
unnamed: A1.14 (D11), R59.2
unnamed: A1.15 (D12), SW1.2
unnamed: A1.16 (D13), SW1.1
unnamed: A1.22 (A3), U37.1 (~SLEEP), U38.1 (~SLEEP), U39.1 (~SLEEP), U40.1 (~SLEEP), U41.1 (~SLEEP), U42.1 (~SLEEP), U43.1 (~SLEEP), U44.1 (~SLEEP), U45.1 (~SLEEP)
unnamed: A1.23 (A4), J2.2, J3.2, R56.1, U37.14 (SDA), U38.14 (SDA), U39.14 (SDA), U40.14 (SDA), U41.14 (SDA), U42.14 (SDA), U43.14 (SDA), U44.14 (SDA), U45.14 (SDA)
unnamed: A1.24 (A5), J2.3, J3.3, R57.1, U37.11 (SCL), U38.11 (SCL), U39.11 (SCL), U40.11 (SCL), U41.11 (SCL), U42.11 (SCL), U43.11 (SCL), U44.11 (SCL), U45.11 (SCL)
unnamed: A1.25 (A6), SW2.1, U47.2 (OUT)
unnamed: A1.26 (A7), R55.2
unnamed: A1.27 (+5V), C10.2, C11.1, R46.1, R47.1, R48.1, R49.1, R50.1, R51.1, R52.1, R53.1, R54.1, R56.2, R57.2, U46.3 (V+), U47.3 (IN)
unnamed: A1.30 (VIN), J4.1 (In)
unnamed: C1.2, C2.2, C3.2, C4.2, C5.2, C6.2, C7.2, C8.2, C9.2, R58.2, U37.12 (VM), U38.12 (VM), U39.12 (VM), U40.12 (VM), U41.12 (VM), U42.12 (VM), U43.12 (VM), U44.12 (VM), U45.12 (VM), U46.5 (IN-)
unnamed: C12.1, R59.1, R60.2
unnamed: C13.1, R60.1, U47.1 (SET)
unnamed: J1.1, R1.2, U1.3 (ANODE), V1.1
unnamed: J1.2, R4.2, R5.2, U4.3 (ANODE), U5.3 (ANODE), V2.2, V3.1
unnamed: J1.3, R8.2, R9.2, U8.3 (ANODE), U9.3 (ANODE), V4.2, V5.1
unnamed: J1.4, R12.2, U12.3 (ANODE), V6.2
unnamed: J1.5, R14.2, R15.2, U14.3 (ANODE), U15.3 (ANODE), V7.2, V8.1
unnamed: J1.6, R18.2, R19.2, U18.3 (ANODE), U19.3 (ANODE), V9.2, V10.1
unnamed: J1.7, R22.2, R23.2, U22.3 (ANODE), U23.3 (ANODE), V11.2, V12.1
unnamed: J1.8, R25.2, U25.3 (ANODE), V13.1
unnamed: J1.9, R28.2, R29.2, U28.3 (ANODE), U29.3 (ANODE), V14.2, V15.1
unnamed: J1.10, R32.2, R33.2, U32.3 (ANODE), U33.3 (ANODE), V16.2, V17.1
unnamed: J1.11, R36.2, U36.3 (ANODE), V18.2
unnamed: J1.14, R2.2, R3.2, U2.3 (ANODE), U3.3 (ANODE), V1.2, V2.1
unnamed: J1.15, R6.2, R7.2, U6.3 (ANODE), U7.3 (ANODE), V3.2, V4.1
unnamed: J1.16, R10.2, R11.2, U10.3 (ANODE), U11.3 (ANODE), V5.2, V6.1
unnamed: J1.17, R13.2, U13.3 (ANODE), V7.1
unnamed: J1.18, R16.2, R17.2, U16.3 (ANODE), U17.3 (ANODE), V8.2, V9.1
unnamed: J1.19, R20.2, R21.2, U20.3 (ANODE), U21.3 (ANODE), V10.2, V11.1
unnamed: J1.20, R24.2, U24.3 (ANODE), V12.2
unnamed: J1.21, R26.2, R27.2, U26.3 (ANODE), U27.3 (ANODE), V13.2, V14.1
unnamed: J1.22, R30.2, R31.2, U30.3 (ANODE), U31.3 (ANODE), V15.2, V16.1
unnamed: J1.23, R34.2, R35.2, U34.3 (ANODE), U35.3 (ANODE), V17.2, V18.1
unnamed: J5.1 (In), SW2.3
unnamed: R1.1, U1.1 (CATHODE)
unnamed: R2.1, U2.1 (CATHODE)
unnamed: R3.1, U3.1 (CATHODE)
unnamed: R4.1, U4.1 (CATHODE)
unnamed: R5.1, U5.1 (CATHODE)
unnamed: R6.1, U6.1 (CATHODE)
unnamed: R7.1, U7.1 (CATHODE)
unnamed: R8.1, U8.1 (CATHODE)
unnamed: R9.1, U9.1 (CATHODE)
unnamed: R10.1, U10.1 (CATHODE)
unnamed: R11.1, U11.1 (CATHODE)
unnamed: R12.1, U12.1 (CATHODE)
unnamed: R13.1, U13.1 (CATHODE)
unnamed: R14.1, U14.1 (CATHODE)
unnamed: R15.1, U15.1 (CATHODE)
unnamed: R16.1, U16.1 (CATHODE)
unnamed: R17.1, U17.1 (CATHODE)
unnamed: R18.1, U18.1 (CATHODE)
unnamed: R19.1, U19.1 (CATHODE)
unnamed: R20.1, U20.1 (CATHODE)
unnamed: R21.1, U21.1 (CATHODE)
unnamed: R22.1, U22.1 (CATHODE)
unnamed: R23.1, U23.1 (CATHODE)
unnamed: R24.1, U24.1 (CATHODE)
unnamed: R25.1, U25.1 (CATHODE)
unnamed: R26.1, U26.1 (CATHODE)
unnamed: R27.1, U27.1 (CATHODE)
unnamed: R28.1, U28.1 (CATHODE)
unnamed: R29.1, U29.1 (CATHODE)
unnamed: R30.1, U30.1 (CATHODE)
unnamed: R31.1, U31.1 (CATHODE)
unnamed: R32.1, U32.1 (CATHODE)
unnamed: R33.1, U33.1 (CATHODE)
unnamed: R34.1, U34.1 (CATHODE)
unnamed: R35.1, U35.1 (CATHODE)
unnamed: R36.1, U36.1 (CATHODE)
unnamed: R37.2, U37.3 (ISEN12), U37.6 (ISEN34)
unnamed: R38.2, U38.3 (ISEN12), U38.6 (ISEN34)
unnamed: R39.2, U39.3 (ISEN12), U39.6 (ISEN34)
unnamed: R40.2, U40.3 (ISEN12), U40.6 (ISEN34)
unnamed: R41.2, U41.3 (ISEN12), U41.6 (ISEN34)
unnamed: R42.2, U42.3 (ISEN12), U42.6 (ISEN34)
unnamed: R43.2, U43.3 (ISEN12), U43.6 (ISEN34)
unnamed: R44.2, U44.3 (ISEN12), U44.6 (ISEN34)
unnamed: R45.2, U45.3 (ISEN12), U45.6 (ISEN34)
unnamed: R55.1, U46.6 (OUT)
unnamed: R58.1, SW2.2, U46.4 (IN+)
unnamed: U1.2 (CATHODE), U1.5 (ANODE), U37.5 (OUT4)
unnamed: U2.2 (CATHODE), U2.5 (ANODE), U37.7 (OUT3)
unnamed: U3.2 (CATHODE), U3.5 (ANODE), U37.4 (OUT2)
unnamed: U10.2 (CATHODE), U10.5 (ANODE), U39.7 (OUT3)
unnamed: U11.2 (CATHODE), U11.5 (ANODE), U39.4 (OUT2)
unnamed: U12.2 (CATHODE), U12.5 (ANODE), U39.2 (OUT1)
unnamed: U13.2 (CATHODE), U13.5 (ANODE), U40.5 (OUT4)
unnamed: U14.2 (CATHODE), U14.5 (ANODE), U40.7 (OUT3)
unnamed: U15.2 (CATHODE), U15.5 (ANODE), U40.4 (OUT2)
unnamed: U16.2 (CATHODE), U16.5 (ANODE), U40.2 (OUT1)
unnamed: U17.2 (CATHODE), U17.5 (ANODE), U41.5 (OUT4)
unnamed: U18.2 (CATHODE), U18.5 (ANODE), U41.7 (OUT3)
unnamed: U19.2 (CATHODE), U19.5 (ANODE), U41.4 (OUT2)
unnamed: U20.2 (CATHODE), U20.5 (ANODE), U41.2 (OUT1)
unnamed: U21.2 (CATHODE), U21.5 (ANODE), U42.5 (OUT4)
unnamed: U22.2 (CATHODE), U22.5 (ANODE), U42.7 (OUT3)
unnamed: U23.2 (CATHODE), U23.5 (ANODE), U42.4 (OUT2)
unnamed: U24.2 (CATHODE), U24.5 (ANODE), U42.2 (OUT1)
unnamed: U25.2 (CATHODE), U25.5 (ANODE), U43.5 (OUT4)
unnamed: U26.2 (CATHODE), U26.5 (ANODE), U43.7 (OUT3)
unnamed: U27.2 (CATHODE), U27.5 (ANODE), U43.4 (OUT2)
unnamed: U28.2 (CATHODE), U28.5 (ANODE), U43.2 (OUT1)
unnamed: U29.2 (CATHODE), U29.5 (ANODE), U44.5 (OUT4)
unnamed: U30.2 (CATHODE), U30.5 (ANODE), U44.7 (OUT3)
unnamed: U31.2 (CATHODE), U31.5 (ANODE), U44.4 (OUT2)
unnamed: U32.2 (CATHODE), U32.5 (ANODE), U44.2 (OUT1)
unnamed: U33.2 (CATHODE), U33.5 (ANODE), U45.5 (OUT4)
unnamed: U34.2 (CATHODE), U34.5 (ANODE), U45.7 (OUT3)
unnamed: U35.2 (CATHODE), U35.5 (ANODE), U45.4 (OUT2)
unnamed: U36.2 (CATHODE), U36.5 (ANODE), U45.2 (OUT1)
unnamed: U4.2 (CATHODE), U4.5 (ANODE), U37.2 (OUT1)
unnamed: U8.2 (CATHODE), U8.5 (ANODE), U38.2 (OUT1)
unnamed: U7.2 (CATHODE), U7.5 (ANODE), U38.4 (OUT2)
unnamed: U5.2 (CATHODE), U5.5 (ANODE), U38.5 (OUT4)
unnamed: U6.2 (CATHODE), U6.5 (ANODE), U38.7 (OUT3)
unnamed: U9.2 (CATHODE), U9.5 (ANODE), U39.5 (OUT4)

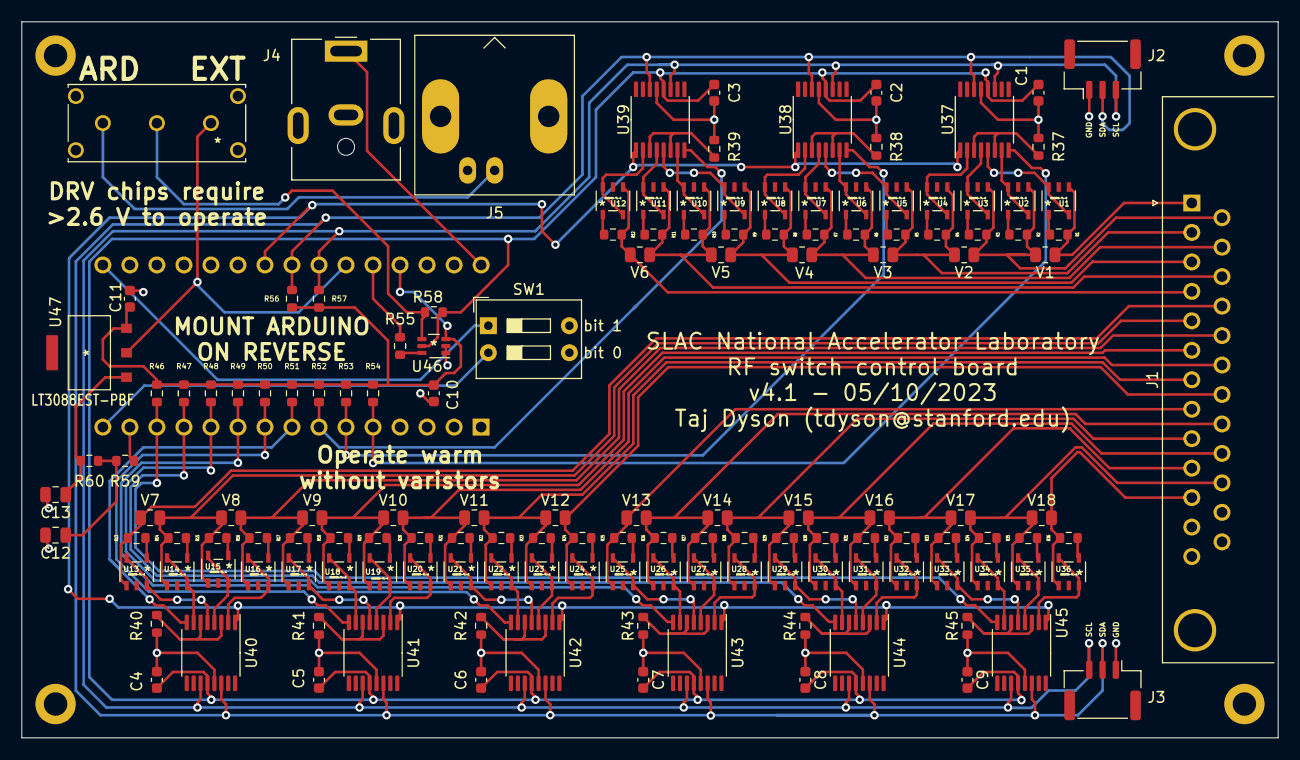
[picture p12: board RF_control_board_v4.1.kicad_pcb from above]

Board: 2 copper layers, 118.1 x 67.3 mm, 146 parts (1 on the bottom side), 128 nets.
