1sadtrombone/rf-switch-firmware/(commit log)

2023-06-08 Added firmware for controlling 4 independent 2-way failsafe switches
    [2WaySwitchesv2.ino, RFSwitchInterfacev1.1.ino]
2023-06-08 Added KiCAD projects for v2 and v4.1 boards
    [RF_control_board_v2-BOM.csv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]
2023-06-08 added updated schematic for v4.1 board.
2023-06-08 removed unnecessary printing
2023-06-08 Added v4 firmware, starting from v1 and adding current sense
2023-06-08 added setting arduino power to init
2023-06-08 changed reported voltage unit
2023-08-03 fixed the opn/cls confusion, and a bug meaning switch 3 wouldn't init
    [RFSwitchInterfacev4.ino]
2023-09-06 fixed the open/close swap confusion
    [RFSwitchInterfacev4.ino]
2023-09-07 reversed the previous change, which was somehow wrong
    [RFSwitchInterfacev4.ino]
2023-09-13 added script that switches 1, 1 every 10 seconds for heating tests
2023-09-13 solved overflow issue with unsigned var
    [RFSwitchInterfacev4-heating_test.ino]
